Bharadhwajsaimatha/novel_line_follow_robot_with_obstacle_sensing/BOM/LineFollowingRobot_BOM.xlsx

Sheet: BOM
Bill of Materials
Project Title: | Line Following Robot |  | Legend | Purchasing takes place every second Friday - Starting on the 21st of April
Group Nr. | Topic 4 Group B |  | to be ordered
Study Course | Embedded Control Solutions |  | ordered
Person in Charge | sai.matha@stud.th-deg.de |  | available in Lab
 |  |  | delivered
Position | Components | Company Name |  | Picture/Image | Price/part | quantities | Total Price | Legend | Weblink | Datasheet | Remarks
1 | Robot Car Kit | Reichelt |  |  | 17.30 € | 1 | 17.3 | available in Lab | https://www.reichelt.de/de/de/roboter-fahrgestell-kit-fuer-raspberry-pi-arduino-robot-car-kit-05-p258657.html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 | https://www.reichelt.de/index.html?ACTION=7&LA=3&OPEN=0&INDEX=0&FILENAME=A300%2FROBOT05-DATASHEET.pdf
2 | Li-Polymer Battery | Eckstein |  |  | 7.95 € | 1 | 7.95 | available in Lab | https://eckstein-shop.de/LiPo-Akku-Lithium-Ion-Polymer-Batterie-37V-2000mAh-mit-JST-PHR-2-Stecker-LP803860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 | https://ecksteinimg.de/Datasheet/ZB07001/LP803860%202000mAH%203.7V%201S1P%20A0.pdf | Using rechargeable batteries instead
3 | DEBO KABELSET | Reichelt |  |  | 5.99 € | 1 | 5.99 | available in Lab | https://www.reichelt.de/entwicklerboards-steckbrueckenkabel-20cm-3x-20-kabel-debo-kabelset8-p280591.html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
4 | L298N driver module | conrad |  |  | 7.49 € | 1 | 7.49 | available in Lab | https://www.conrad.de/de/p/joy-it-motormodul-2-u-4-phasen-6-bis-12v-entwickler-platine-1573541.html | https://asset.conrad.com/media10/add/160267/c1/-/en/001573541DS02/datenblatt-1573541-joy-it-motormodul-2-u-4-phasen-6-bis-12v-entwickler-platine.pdf
5 | Node MCU ESP32 module | conrad |  |  | 13.99 € | 1 | 13.99 | available in Lab | https://www.conrad.de/de/p/joy-it-entwickler-platine-node-mcu-esp32-modul-1656367.html | https://asset.conrad.com/media10/add/160267/c1/-/en/001656367DS01/datenblatt-1656367-joy-it-entwickler-platine-node-mcu-esp32-modul.pdf
6 | IR infrared module | roboter-bausatz |  |  | 1.15 € | 8 | 9.2 | to be ordered | https://www.roboter-bausatz.de/p/ir-infrarot-modul-fuer-kollissions-und-hinderniserkennung?sPartner=8
7 | Black Tape | Reichelt |  |  | 0.60 € | 1 | 0.6 | available in Lab | https://www.reichelt.de/vde-isolierband-10-m-breite-15-mm-schwarz-isoband-sw-p8975.html?PROVID=2788 |  | for the track
8 | Push Button | Seed |  |  | 0.62 € | 1 | 0.62 | to be ordered | https://www.reichelt.de/de/en/miniature-push-button-on-0-5-a-250-vac-red-t-113a-rt-p45166.html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
9 | Resistors 330E | Vishhay |  |  | 0.05 € | 5 | 0.25 | to be ordered | https://www.reichelt.de/de/en/thin-film-resistor-axial-0-6-w-330-ohm-1--vi-mbb02070c3300-p233724.html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
10 | Clear LED's | NICHIA |  |  | 0.05 € | 5 | 0.25 | to be ordered | https://www.reichelt.de/de/en/led-3-mm-bedrahtet-rot-700-mcd-30--quad-2111o155-p347905.html?trstct=pol_1&nbc=1
 |  |  |  |  | Total | 25 | 63.64 €

Sheet: Well known shops
Shopname | Link | Product examples
Eckstein Komponente | https://eckstein-shop.de/Startseite | Everything about Arduino, Adafruit, Seeed etc…
Conrad | https://www.conrad.de | Tools, multimedia, wires, connectors, education, electromechanics, automation, etc…
Reichelt | https://www.reichelt.de | Raspberry, Arduino, Power supply, metrology, tools, network technology, etc…
Mouser | https://www.mouser.de | Semiconductors, sensors, actuators, optoelectronics, etc….
Digikey | https://www.digikey.de | Semiconductors, sensors, actuators, optoelectronics, etc….
Böttcher | https://www.bueromarkt-ag.de | Office products, paper, Work safety, electronics, etc…
Voelkner | https://www.voelkner.de | Multimedia, power supply, tools, sensors, wires, etc…
Bürklin | https://www.buerklin.com/de/ | Semiconductors, sensors, actuators, optoelectronics, etc….
BerryBase | https://www.berrybase.de | Raspberry, robotics, sensors, modules, tools, metrology
Würth | https://eshop.wuerth.de/de/DE/EUR/ | Tools, screws, nuts and bolts, etc...
Contorion | https://www.contorion.de | Tools, screws, nuts and bolts, etc...
Gemmel-Metalle | https://www.gemmel-metalle.de | aluminum, plexiglass, steel, plates, pipes, angle plates, etc…
Buyzero | https://buyzero.de | Raspberry, Arduino, Waveshare, NVDIA
Roboter Bausatz-Shop | https://www.roboter-bausatz.de/?sPartner=8 | DIY-Electronics, 3D-Printing, Tools, Wires
Robot Shop | https://www.robotshop.com/de/de/ | Robotics, Microcontroller, Sensors
MiniPc | https://www.minipc.de | Computer components
TME | https://www.tme.eu/de/ | Embedded Systems, semiconductors, cases, wires,
