Bharadhwajsaimatha/novel_line_follow_robot_with_obstacle_sensing/Test_paths/path.pdf

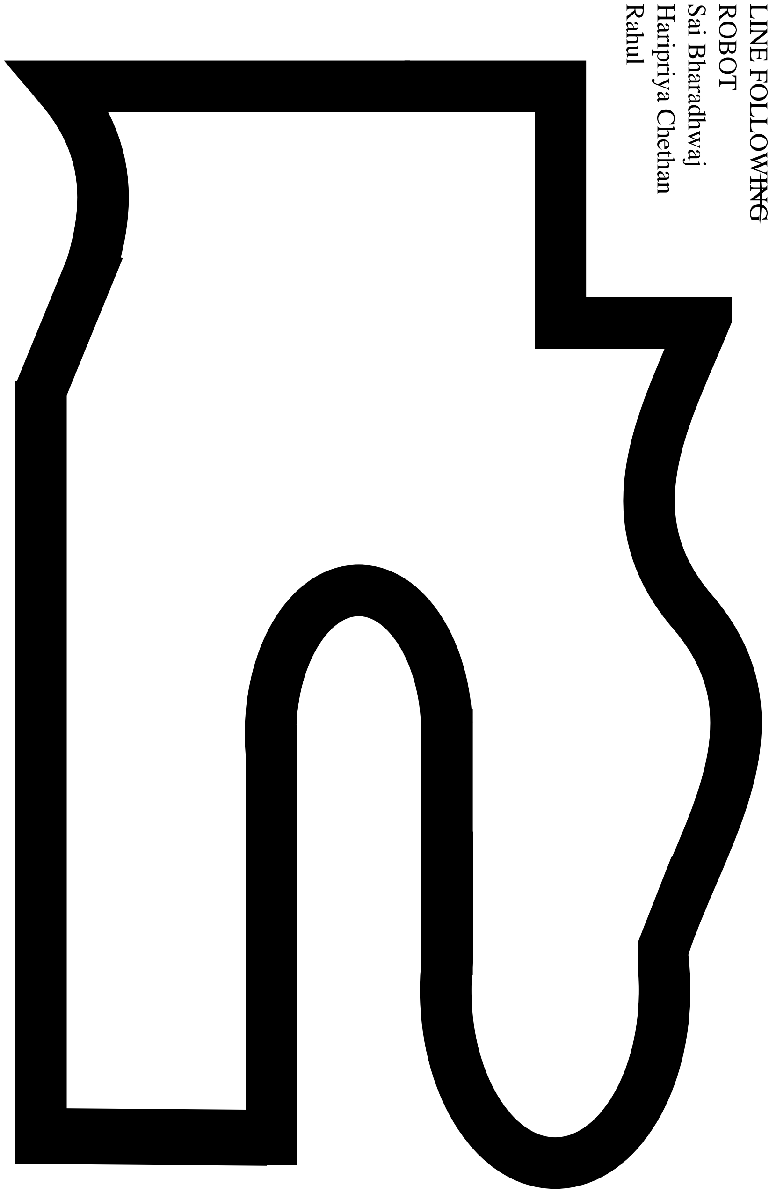
[picture p21: figure]
Sai; ROBOT; LINE FOLLOWING; Bharadhwaj; Haripriya Chethan; Rahul
